JakubFialkowski/Quadrocopter/DSC_0616.JPG

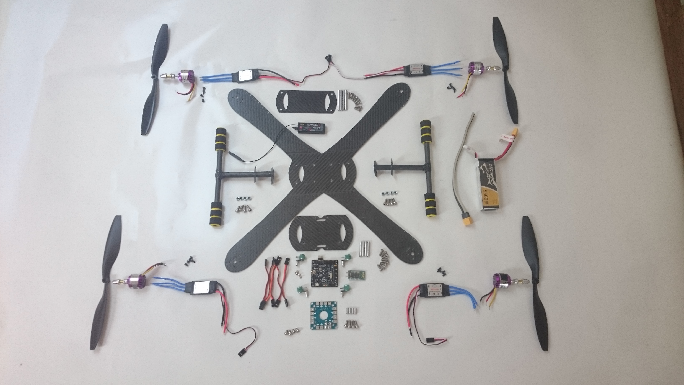
DSC_0616.JPG
