JakubFialkowski/Quadrocopter/DSC_0617.JPG

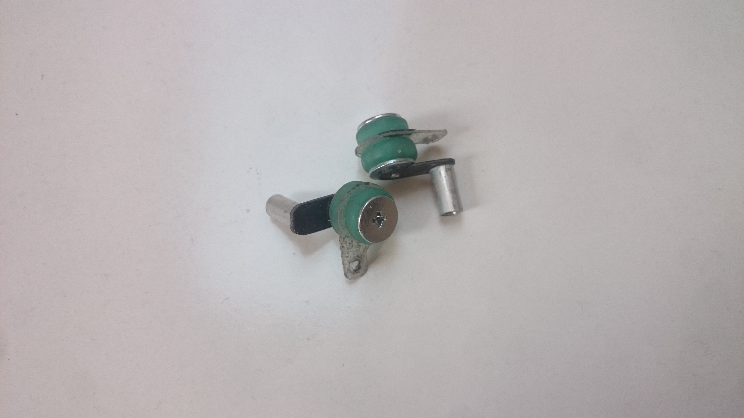
DSC_0617.JPG
