JakubFialkowski/Quadrocopter/README.md

<h1><b><big># Quadrocopter</big></b></h1>
Projekt przedstawia proces powstawania latającej platformy czterowirnikowej.

Model konstrukcji - Inventor 2017
Materiał konstrukcyjny - włókno węglowe, włókno szklane, Coremat, aluminium.

Szczegółowy opis zamieszczony w Model konstrukcji.pdf
