JakubFialkowski/Quadrocopter/DSC_0532.JPG

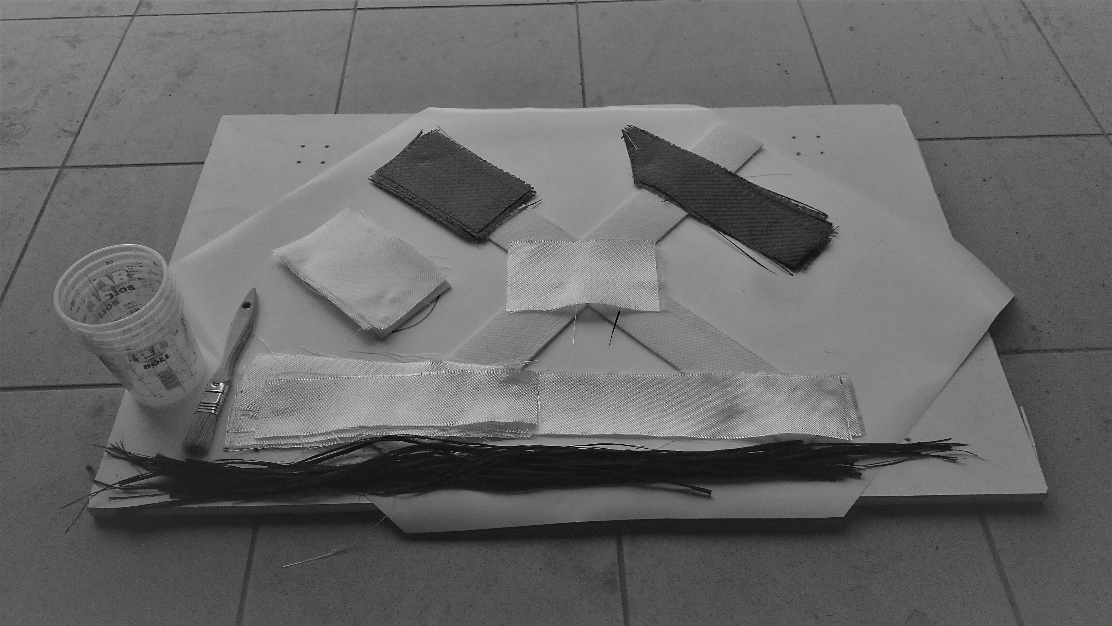
DSC_0532.JPG
