JakubFialkowski/Quadrocopter/DSC_0533.JPG

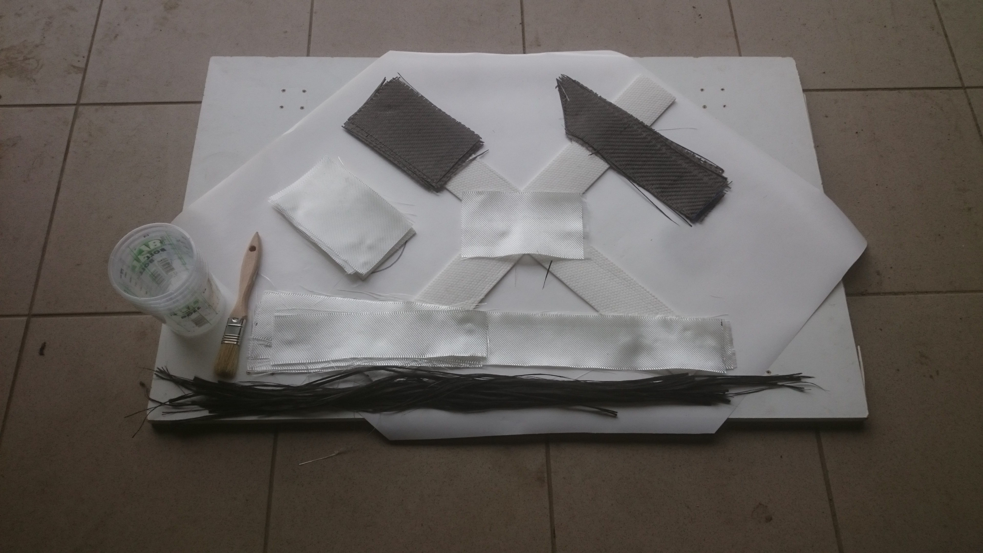
DSC_0533.JPG
