JakubFialkowski/Quadrocopter/DSC_0548.JPG

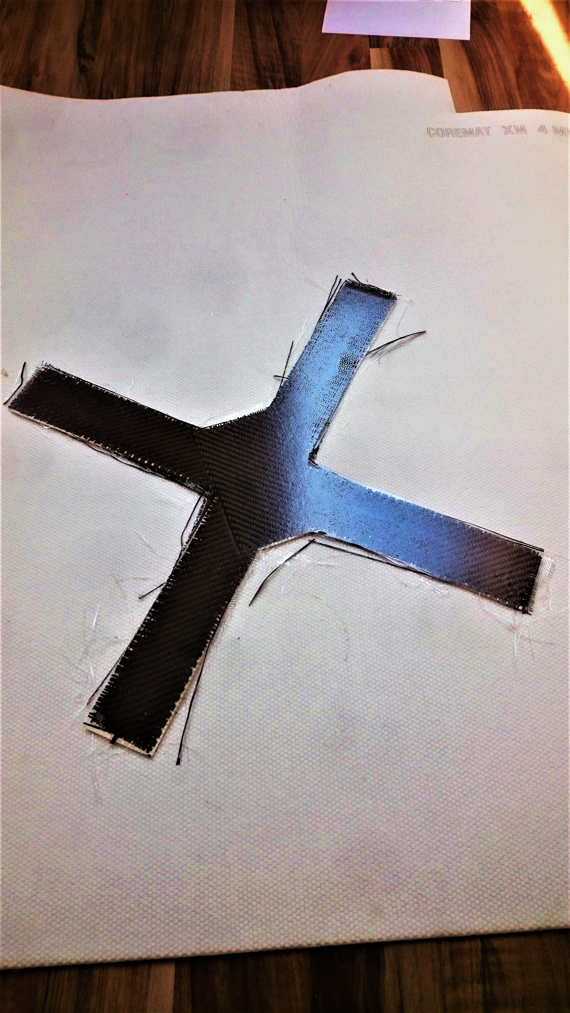
DSC_0548.JPG
