JakubFialkowski/Quadrocopter/DSC_0587.JPG

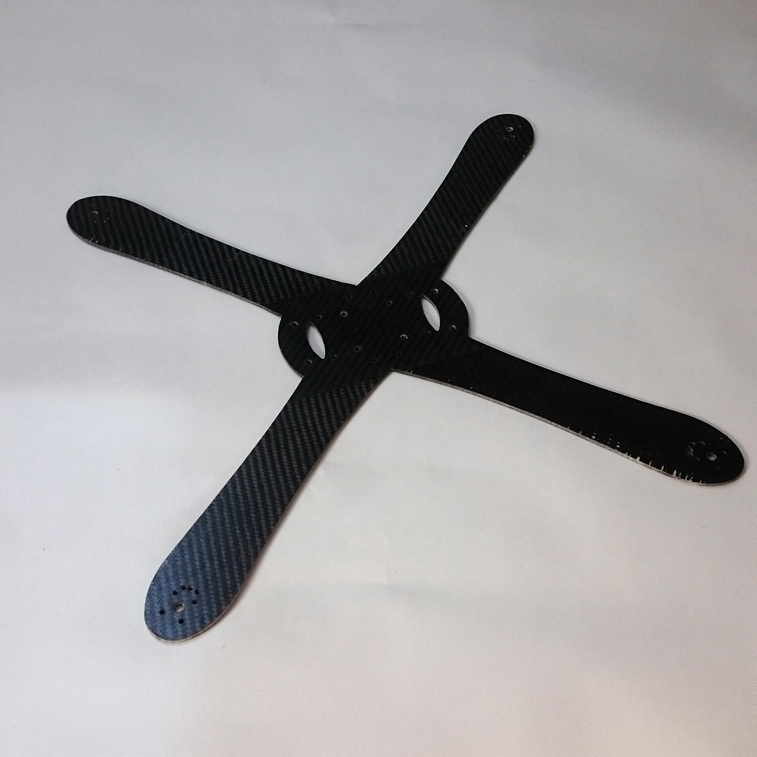
DSC_0587.JPG
