JakubFialkowski/Quadrocopter/DSC_0589.JPG

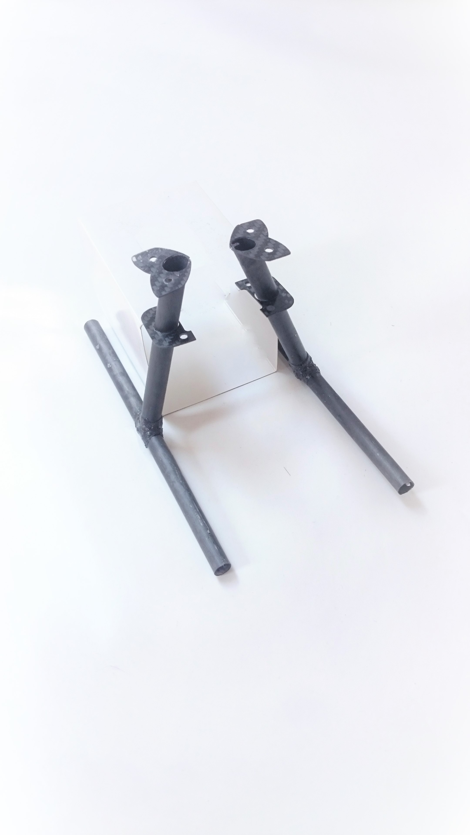
DSC_0589.JPG
