JakubFialkowski/Quadrocopter/DSC_0627.JPG

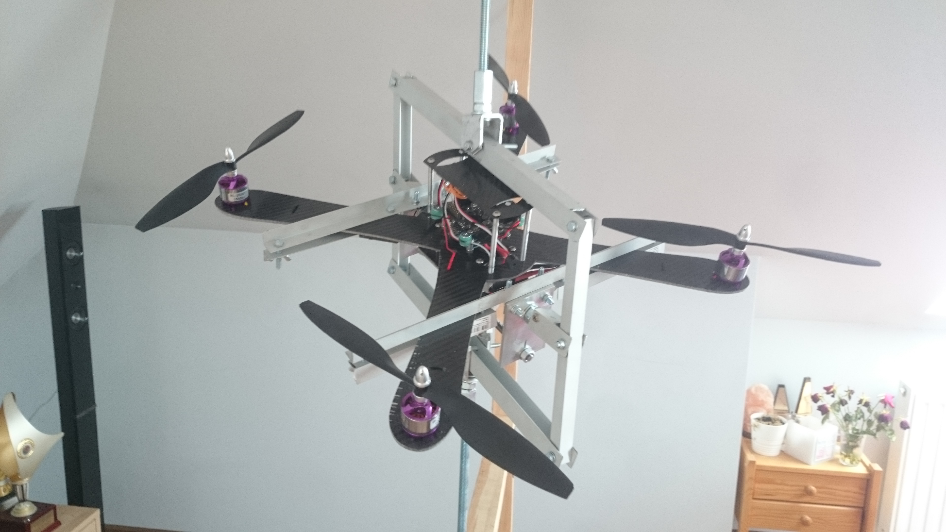
DSC_0627.JPG
