JakubFialkowski/Quadrocopter/(list of files, cad)

Other CAD files:
mocowanie_podwozia_dol.ipt
mocowanie_podwozia_gora.ipt
mocowanie_smigla.ipt
multiwii.ipt
plyta_odbiornik.ipt
podwozie.ipt
płyta_pod_lipol.ipt
rama.ipt
silnik.ipt
łopata_lewa.ipt
łopata_prawa.ipt
